jblasques/Voltage-and-current-measurement-for-sailing-boat/Schematic detailed page 1.pdf

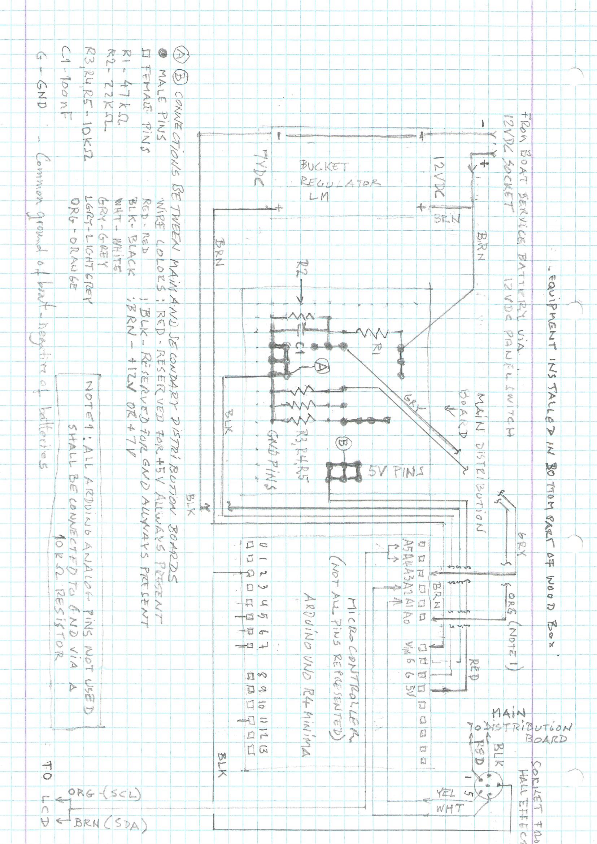
[picture p4: page 1]
