jblasques/Voltage-and-current-measurement-for-sailing-boat/Schematic detailed page 2.pdf

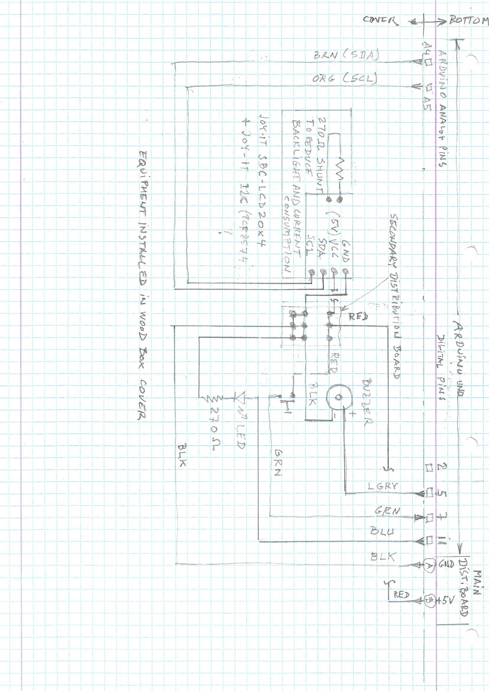
[picture p5: page 1]
