jblasques/Voltage-and-current-measurement-for-sailing-boat/Schematic simplified.pdf

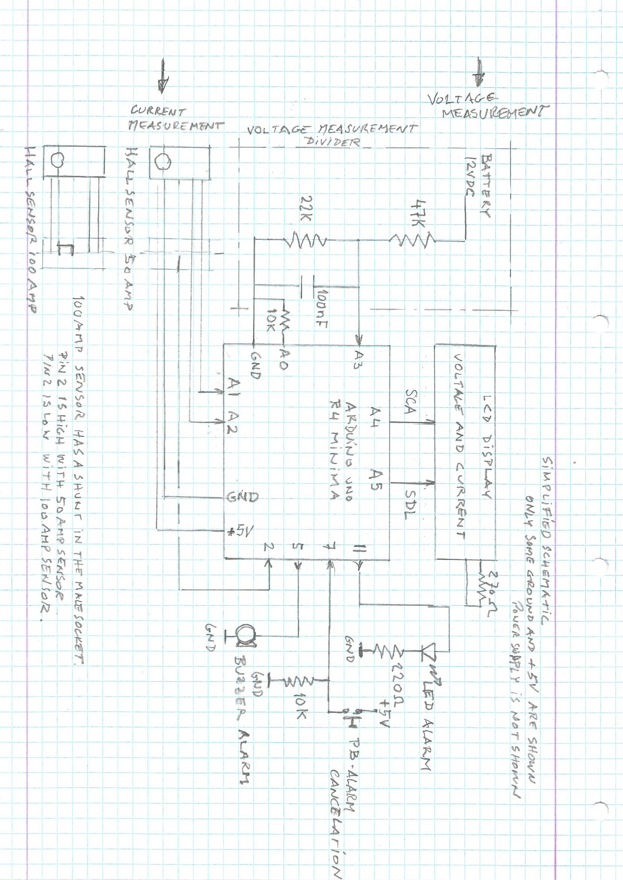
[picture p6: page 1]
